SHOMI98/EcoStopBrakeStarter/(commit log)

2019-06-02 AVRライターについて追記
2019-06-03 出力端子の保護抵抗接続位置について追記
2019-06-03 再始動操作動画追加
2019-06-03 誤字修正
2019-06-03 Update README.md
    Eco-Stopと車両のN信号配線間に割り込ませる旨を追記
2019-06-04 Update README.md
    再始動後の注意点を記載
2019-06-09 注意事項更新
2019-06-17 動作確認の速度を修正
2019-06-17 坂道での再始動操作について追記
